ruralbytest/sesame-robot/docs/README.md

# Documentation

Documentation for the Sesame Robot project.

- **build-guide/** - Build guide with photos
- **images/** - Photos and diagrams
- **two-brain-build/** - Design record for the fork's body + round-head build: wiring for the XIAO and Glyph S3, PCA9685 variant, UART protocol, power, lessons learned
- **wiring-guide/** - Wiring instructions
