ruralbytest/sesame-robot/hardware/printing/stl/top-covers/aurora-head/Aurora-Ear-Cat-v200.stl

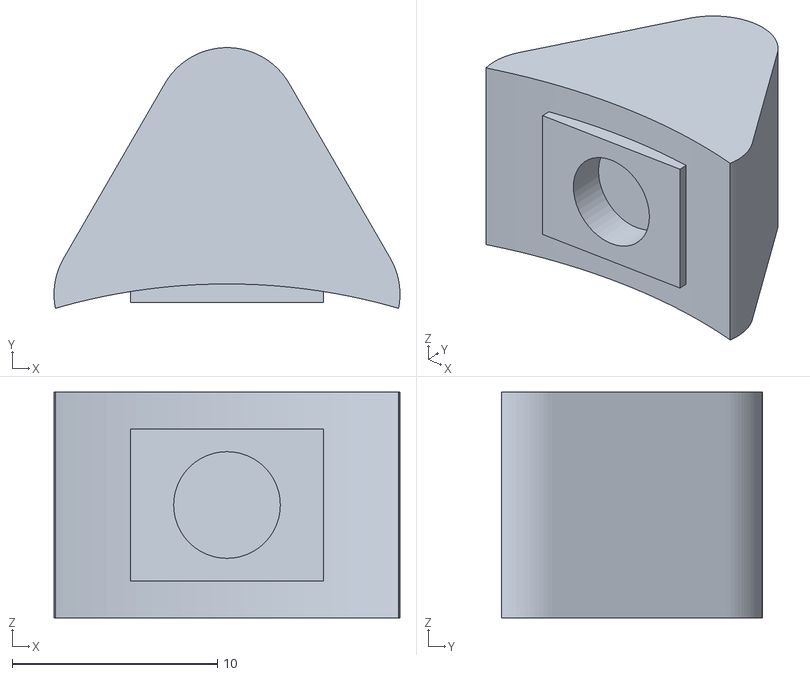
[picture p11: CAD file, 2026-10-20]
hardware/printing/stl/top-covers/aurora-head/Aurora-Ear-Cat-v200.stl
16.9 x 12.7 x 11.0
