ruralbytest/sesame-robot/hardware/printing/stl/top-covers/aurora-head/Aurora-Ear-Bunny-v200.stl

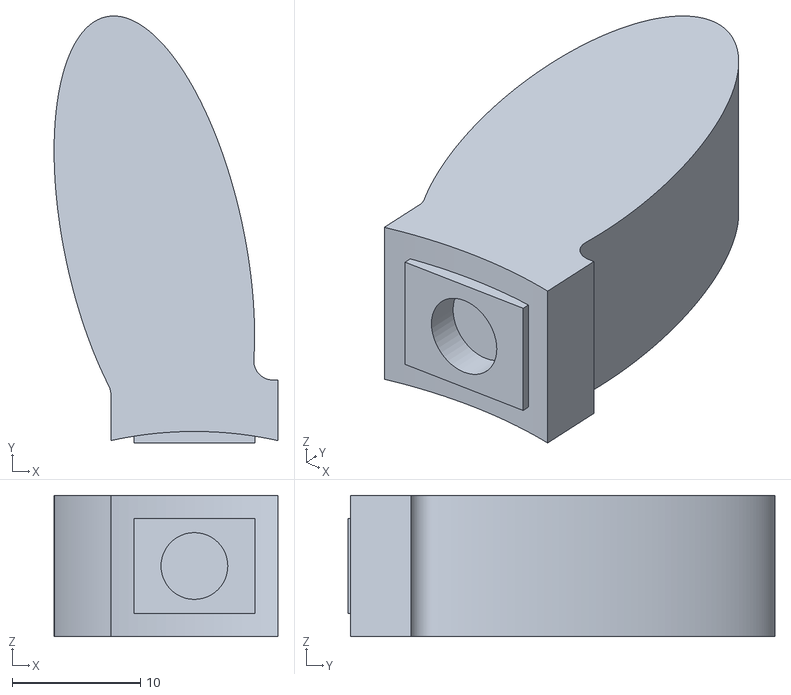
[picture p12: CAD file, 2026-10-20]
hardware/printing/stl/top-covers/aurora-head/Aurora-Ear-Bunny-v200.stl
17.4 x 33.2 x 11.0
