ruralbytest/sesame-robot/hardware/printing/stl/top-covers/aurora-head/Aurora-Head-Socket-Clamp-v200.stl

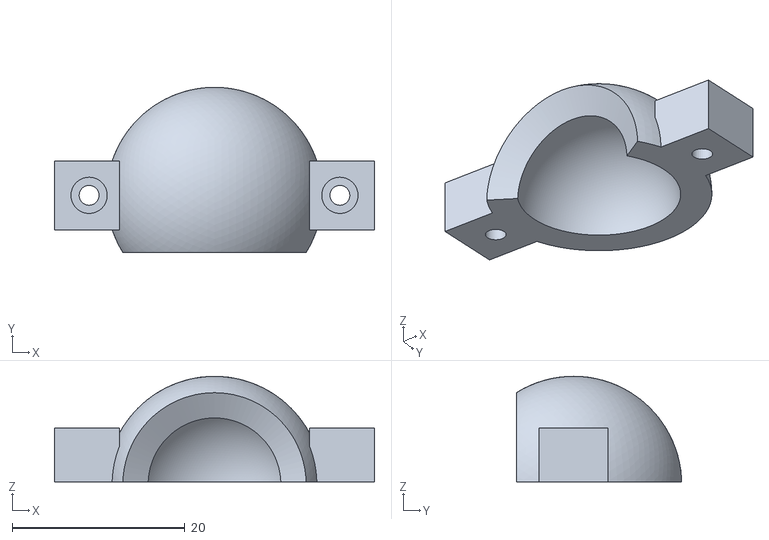
[picture p13: CAD file, 2026-10-20]
hardware/printing/stl/top-covers/aurora-head/Aurora-Head-Socket-Clamp-v200.stl
37.0 x 19.1 x 12.2
