ruralbytest/sesame-robot/hardware/printing/stl/top-covers/aurora-head/Aurora-Ear-Antenna-v200.stl

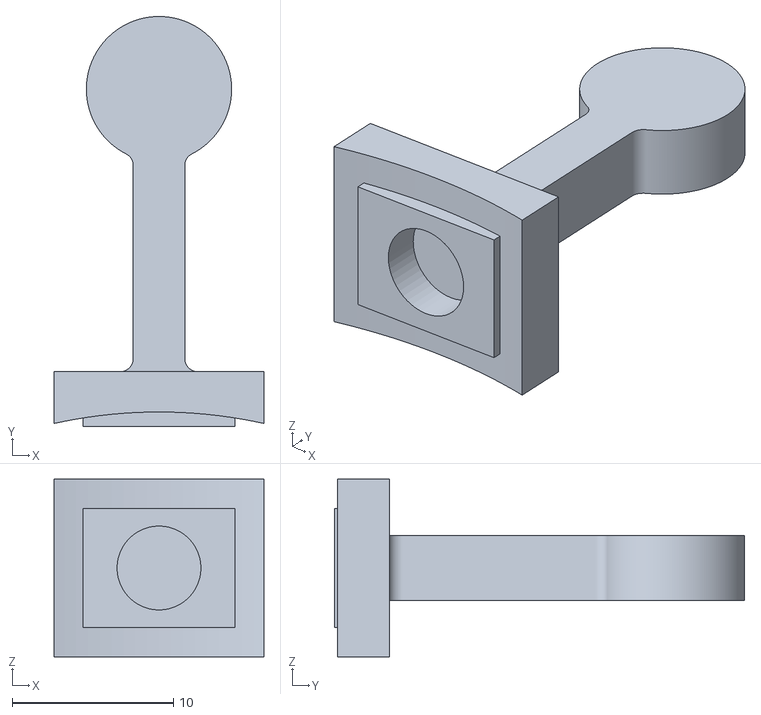
[picture p14: CAD file, 2026-10-20]
hardware/printing/stl/top-covers/aurora-head/Aurora-Ear-Antenna-v200.stl
13.0 x 25.4 x 11.0
