ruralbytest/sesame-robot/hardware/printing/stl/top-covers/aurora-head/Aurora-Head-Body-v200.stl

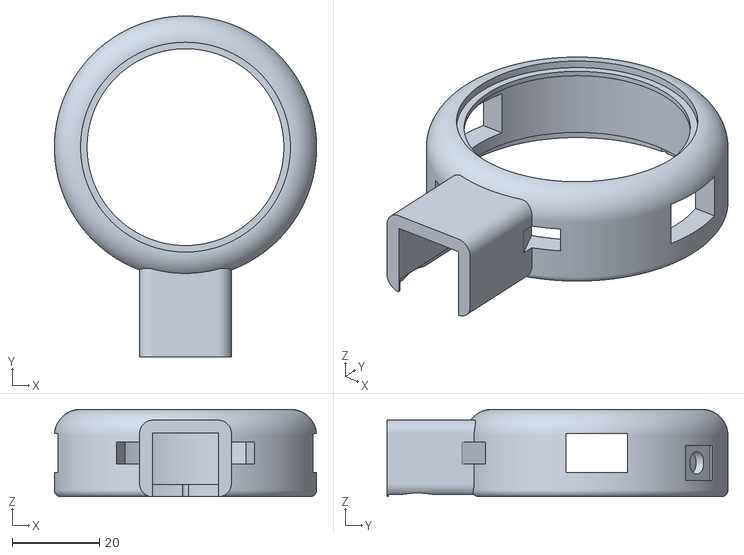
[picture p15: CAD file, 2026-10-20]
hardware/printing/stl/top-covers/aurora-head/Aurora-Head-Body-v200.stl
60.0 x 78.0 x 20.0
