ruralbytest/sesame-robot/hardware/printing/stl/top-covers/aurora-head/Aurora-Head-Back-Cap-v200.3mf

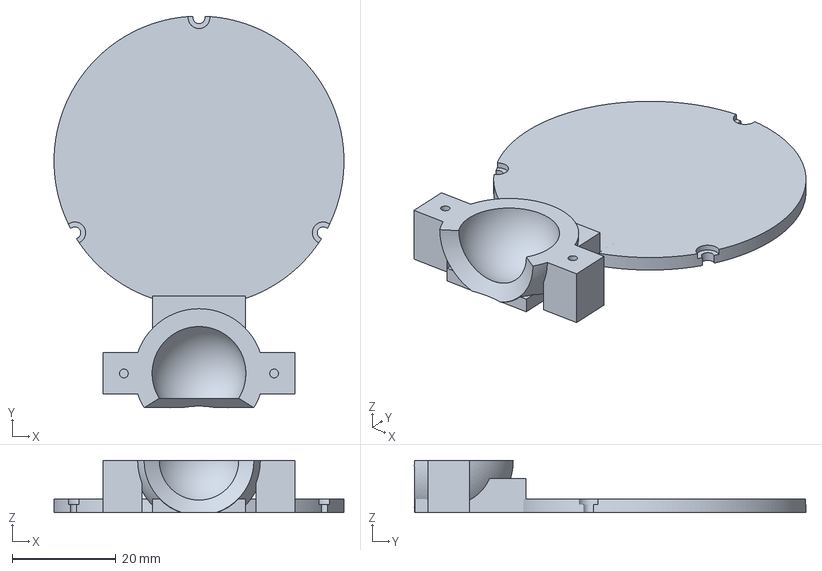
[picture p16: CAD file, 2026-10-20]
hardware/printing/stl/top-covers/aurora-head/Aurora-Head-Back-Cap-v200.3mf
56.0 x 75.6 x 10.1 mm
