ruralbytest/sesame-robot/hardware/printing/stl/top-covers/aurora-head/Aurora-Ear-Bear-v200.stl

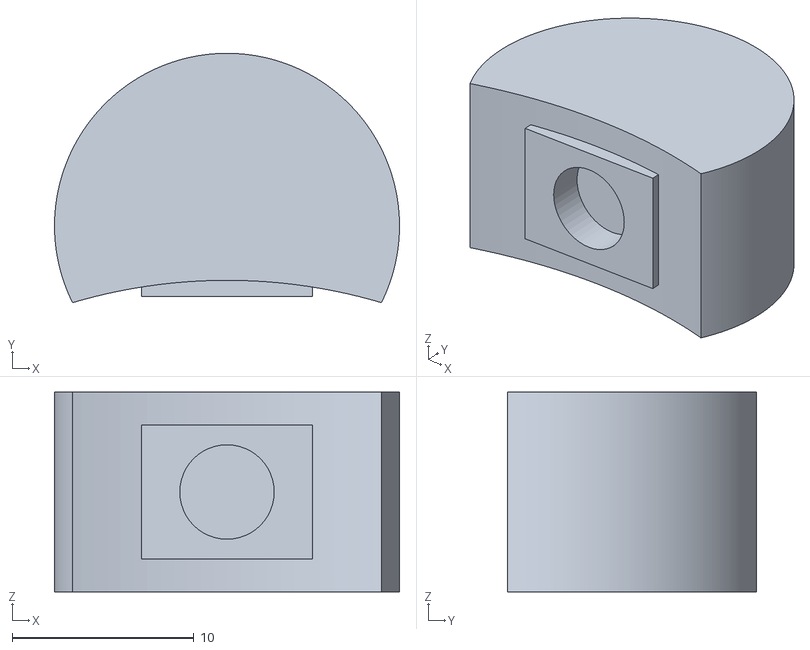
[picture p17: CAD file, 2026-10-20]
hardware/printing/stl/top-covers/aurora-head/Aurora-Ear-Bear-v200.stl
19.0 x 13.7 x 11.0
