ruralbytest/sesame-robot/hardware/printing/stl/top-covers/aurora-head/Top-Cover-Aurora-v200.stl

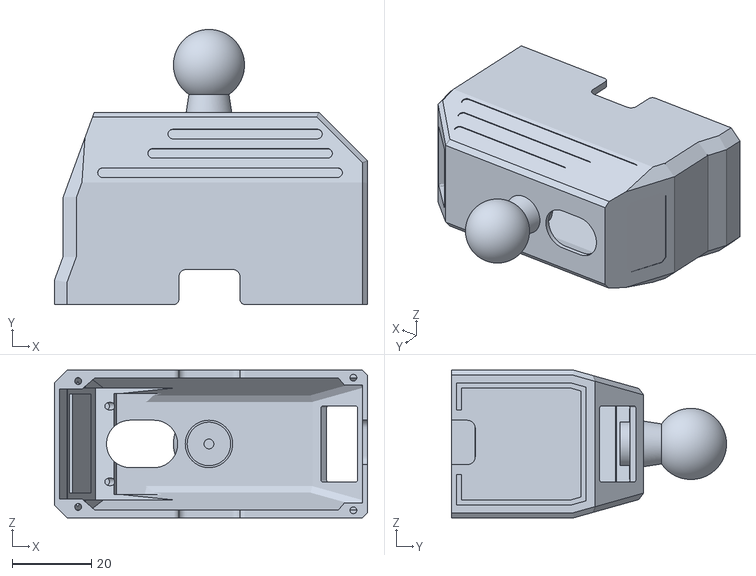
[picture p18: CAD file, 2026-10-20]
hardware/printing/stl/top-covers/aurora-head/Top-Cover-Aurora-v200.stl
79.2 x 69.6 x 37.4
