ruralbytest/sesame-robot/(list of files, cad)

Other CAD files:
hardware/printing/stl/top-covers/aurora-head/Aurora-Head-Back-Cap-v200.stl
