ruralbytest/sesame-robot/hardware/printing/stl/top-covers/README.md

# Top Cover Styles

## Enclosed v100
Current modern version of sesame top cover, includes 5mm x 2mm magnet slots for hats! Front display wires are covered, supports multicolor details.

## Cat v100
Modern Version of the enclosed top cover with cat ears instead of stubby ears! Updated with all current features with magnet support for hats, and multicolor details.

## No Ears v100
Template for designing your own ears for Sesame. The areas right next to where the ears ussually go is a little thin so this version is only really meant for desiging ears onto. (Includes all previously mentioned features)

## Aurora Head v200
Top cover for the Waveshare 1.43" round AMOLED head (ESP32-S3-Touch-AMOLED-1.43C). The display sits in a round head on a ball joint, so you can tilt and turn it by hand, with swappable magnet-mounted ears (cat, bunny, bear, antenna). The OLED window is filled in. Built on the No-Ears cover so leg clearance is unchanged. See [aurora-head](aurora-head/README.md) for the parts, screws and assembly steps.
