ruralbytest/sesame-robot/firmware/head-firmware/sesame-aurora/Audio.cpp

#include "Audio.h"
#include <driver/i2s_tdm.h>
#include <math.h>
#include "src/esp_codec_dev/include/esp_codec_dev.h"
#include "src/esp_codec_dev/include/esp_codec_dev_defaults.h"

i2c_master_bus_handle_t sharedBus=nullptr;
static i2c_master_dev_handle_t touch=nullptr;
static esp_codec_dev_handle_t speaker=nullptr,microphone=nullptr;
static QueueHandle_t notes=nullptr;
std::atomic<float> micLevel{0};
std::atomic<uint32_t> audioBlocks{0},audioErrors{0},soundUntil{0};
std::atomic<bool> soundEnabled{true};
// The amplifier (PA) is switched off between sounds to save power and avoid
// hiss. It gets a short silent lead-in after switching on so the start of a
// sound isn't clipped, and stays on briefly afterwards so the tail plays out.
std::atomic<bool> ampOn{false};
static constexpr gpio_num_t PA_PIN=GPIO_NUM_46;
static constexpr int AMP_WARMUP_BLOCKS=2;     // 2 x 16 ms of silence after switching on
static constexpr uint32_t AMP_OFF_AFTER_MS=500;
static void setAmp(bool on){gpio_set_level(PA_PIN,on);ampOn.store(on);}
// Volume 0..100 maps to -50..0 dB in the codec; 100 = full DAC level.
// Raise CHIRP_AMPLITUDE/SPEAKER_VOLUME together if calls are still too quiet.
static constexpr int SPEAKER_VOLUME=100;
static constexpr float CHIRP_AMPLITUDE=24000;
bool micReady=false,speakerReady=false;

// A sound is a short series of tones. Each tone glides from f0 to f1 Hz,
// bends up by `arch` Hz in the middle, wobbles by vibDepth Hz at vibHz,
// and lasts ms milliseconds. f0 = 0 is a silent gap.
struct Tone{uint16_t f0,f1;int16_t arch;uint8_t vibHz;uint8_t vibDepth;uint16_t ms;};
struct Sound{uint8_t count;Tone tones[7];};
#define GAP(ms) {0,0,0,0,0,ms}
#define NOTE(f,ms) {f,f,0,0,0,ms}
static const Sound sounds[SND_COUNT]={
  // Original pet calls
  {1,{{700,700,380,0,0,350}}},                                   // chirp
  {1,{{520,520,380,0,0,350}}},                                   // affection
  {1,{{180,180,0,6,65,700}}},                                    // purr
  // Moods: CURIOUS, HAPPY, LOVE, SLEEPY, PARTY, SURPRISED, BRAVE, SAD, THINKING
  {1,{{500,850,0,0,0,260}}},                                     // curious: rising "hm?"
  {3,{{700,1000,0,0,0,120},GAP(40),{800,1200,0,0,0,150}}},       // happy: two bright chirps
  {3,{{650,600,0,6,30,220},GAP(60),{560,520,0,6,30,280}}},       // love: soft "mm-mm"
  {1,{{600,250,60,5,15,700}}},                                   // sleepy: long yawn
  {4,{NOTE(523,90),NOTE(659,90),NOTE(784,90),NOTE(1047,160)}},   // party: arpeggio
  {1,{{400,1400,0,0,0,160}}},                                    // surprised: quick upward sweep
  {3,{{220,260,0,30,20,160},GAP(40),{330,330,0,30,20,260}}},     // brave: low growl
  {3,{{700,420,0,5,15,420},GAP(60),{450,330,0,5,15,320}}},       // sad: falling sigh
  {2,{{300,300,0,5,10,320},{300,430,0,0,0,160}}},                // thinking: "hmm?"
  // Body moves, in Move order
  {5,{{600,660,0,0,0,60},GAP(50),{520,580,0,0,0,60},GAP(50),{600,660,0,0,0,60}}},   // forward: pit-pat steps
  {3,{NOTE(1000,130),GAP(110),NOTE(1000,130)}},                  // backward: reversing beeps
  {1,{{950,600,0,0,0,220}}},                                     // left: falling swoop
  {1,{{600,950,0,0,0,220}}},                                     // right: rising swoop
  {3,{{480,280,80,5,15,650},GAP(80),{300,260,0,0,0,180}}},       // rest: yawn and sigh
  {3,{NOTE(523,100),GAP(30),NOTE(784,240)}},                     // stand: ta-da
  {3,{{700,900,0,0,0,130},GAP(40),{900,650,0,0,0,220}}},         // wave: "hel-lo"
  {6,{NOTE(523,90),NOTE(659,90),NOTE(784,90),NOTE(1047,90),NOTE(784,90),NOTE(1047,180)}}, // dance
  {5,{{400,900,0,0,0,50},GAP(50),{450,950,0,0,0,50},GAP(50),{500,1000,0,0,0,50}}},  // swim: bubbles
  {3,{NOTE(1250,90),GAP(30),NOTE(1570,200)}},                    // point: "ding-ding"
  {5,{{250,330,0,0,0,110},GAP(120),{250,330,0,0,0,110},GAP(120),{280,380,0,0,0,160}}}, // pushup: hup hup hup
  {3,{NOTE(784,120),NOTE(659,120),NOTE(523,220)}},               // bow: polite descent
  {1,{{900,1200,150,8,40,380}}},                                 // cute: "nya~"
  {1,{{300,1200,0,15,250,600}}},                                 // freaky: wild warble
  {1,{{500,700,0,10,120,520}}},                                  // worm: wiggly glide
  {1,{{700,700,0,25,200,420}}},                                  // shake: fast trill
  {3,{{450,350,0,0,0,160},GAP(60),{380,500,0,0,0,220}}},         // shrug: "meh?"
  {1,{{600,150,0,4,20,900}}},                                    // dead: long fall
  {7,{NOTE(1500,30),GAP(60),NOTE(1500,30),GAP(60),NOTE(1500,30),GAP(60),NOTE(1800,40)}}, // crab: clicks
};
static uint32_t soundMs(int id){uint32_t ms=0;for(int i=0;i<sounds[id].count;i++)ms+=sounds[id].tones[i].ms;return ms;}

void playSound(int id){if(notes&&speakerReady&&soundEnabled.load()&&id>=0&&id<SND_COUNT)xQueueOverwrite(notes,&id);}

static void audioTask(void*) {
  int16_t in[512],out[512]; // 256 stereo samples: 16 ms at 16 kHz
  int sound=-1,tone=0,pos=0,len=0,warmup=0;float phase=0;uint32_t quietSince=millis();
  if(speakerReady)setAmp(false); // the codec switched it on when it opened
  for(;;){
    int request=0;
    if(xQueueReceive(notes,&request,0)==pdTRUE){
      sound=request;tone=0;pos=0;len=sounds[sound].tones[0].ms*16;
      if(!ampOn.load()){setAmp(true);warmup=AMP_WARMUP_BLOCKS;}
      soundUntil.store(millis()+warmup*16+soundMs(sound)+350);
    }
    if(!soundEnabled.load())sound=-1; // muted mid-sound: drop it so the amp can switch off
    if(micReady){
      if(esp_codec_dev_read(microphone,in,sizeof(in))==ESP_OK){
        // Remove DC separately for both channels; use the louder microphone.
        float mean[2]={0,0},sum[2]={0,0};
        for(int i=0;i<512;i++)mean[i&1]+=in[i]/256.f;
        for(int i=0;i<512;i++)sum[i&1]+=fabsf(in[i]-mean[i&1]);
        float level=fmaxf(sum[0],sum[1])/256.f/32768.f;
        micLevel.store(level);audioBlocks.fetch_add(1);
      }else{audioErrors.fetch_add(1);vTaskDelay(pdMS_TO_TICKS(10));}
    }
    for(int i=0;i<256;i++){
      float sample=0;
      if(sound>=0 && soundEnabled.load() && !warmup){
        const Tone& k=sounds[sound].tones[tone];
        if(k.f0){
          float t=pos/16000.f,u=pos/(float)len;
          float f=k.f0+(k.f1-k.f0)*u+k.arch*sinf(u*3.14159f)+k.vibDepth*sinf(6.2831853f*k.vibHz*t);
          float envelope=fminf(1.f,u*18)*fminf(1.f,(1-u)*12);
          // Synthesized calls with a soft envelope per tone. Peak is
          // 1.18 * CHIRP_AMPLITUDE, kept just under int16 full scale.
          phase+=6.2831853f*f/16000; if(phase>6.2831853f)phase-=6.2831853f;
          sample=(sinf(phase)+.18f*sinf(phase*2))*envelope*CHIRP_AMPLITUDE;
        }
        if(++pos>=len){
          pos=0;
          if(++tone>=sounds[sound].count)sound=-1;
          else len=sounds[sound].tones[tone].ms*16;
        }
      }
      out[i*2]=out[i*2+1]=(int16_t)sample;
    }
    if(warmup)warmup--;
    if(sound>=0)quietSince=millis();
    else if(ampOn.load()&&millis()-quietSince>AMP_OFF_AFTER_MS)setAmp(false);
    if(speakerReady){if(esp_codec_dev_write(speaker,out,sizeof(out))!=ESP_OK){audioErrors.fetch_add(1);vTaskDelay(pdMS_TO_TICKS(10));}}
    if(!micReady&&!speakerReady)vTaskDelay(pdMS_TO_TICKS(30));
  }
}

bool readTouch(int &x,int &y){
  if(!touch)return false;uint8_t reg=2,b[5]={};
  if(i2c_master_transmit_receive(touch,&reg,1,b,5,20)!=ESP_OK)return false;
  if(!(b[0]&15)||(b[1]>>6)==1)return false;
  // Panel MADCTL rotates 180 degrees; match its visible coordinates.
  x=465-(((b[1]&15)<<8)|b[2]);y=465-(((b[3]&15)<<8)|b[4]);
  return x>=0&&x<466&&y>=0&&y<466;
}

bool initPeripherals(){
  pinMode(18,OUTPUT);digitalWrite(18,HIGH); // codec LDO (official BSP)
  pinMode(46,OUTPUT);digitalWrite(46,LOW); // PA off until codec is ready
  i2c_master_bus_config_t bus={};bus.i2c_port=I2C_NUM_0;bus.sda_io_num=GPIO_NUM_47;bus.scl_io_num=GPIO_NUM_48;
  bus.clk_source=I2C_CLK_SRC_DEFAULT;bus.glitch_ignore_cnt=7;bus.flags.enable_internal_pullup=true;
  if(i2c_new_master_bus(&bus,&sharedBus)!=ESP_OK)return false;
  pinMode(16,OUTPUT);digitalWrite(16,HIGH);delay(20);digitalWrite(16,LOW);delay(20);digitalWrite(16,HIGH);delay(150);
  if(i2c_master_probe(sharedBus,0x15,30)==ESP_OK){
    i2c_device_config_t t={};t.dev_addr_length=I2C_ADDR_BIT_LEN_7;t.device_address=0x15;t.scl_speed_hz=400000;
    i2c_master_bus_add_device(sharedBus,&t,&touch);
  }
  bool hasSpk=i2c_master_probe(sharedBus,0x18,30)==ESP_OK;
  bool hasMic=i2c_master_probe(sharedBus,0x40,30)==ESP_OK;
  Serial.printf("I2C touch=%d speaker=%d microphone=%d\n",touch!=nullptr,hasSpk,hasMic);
  if(!hasSpk&&!hasMic)return touch!=nullptr;
  i2s_chan_handle_t tx=nullptr,rx=nullptr;
  i2s_chan_config_t ch=I2S_CHANNEL_DEFAULT_CONFIG(I2S_NUM_0,I2S_ROLE_MASTER);ch.auto_clear=true;
  if(i2s_new_channel(&ch,&tx,&rx)!=ESP_OK)return touch!=nullptr;
  i2s_tdm_config_t cfg={};cfg.clk_cfg=I2S_TDM_CLK_DEFAULT_CONFIG(16000);
  cfg.slot_cfg=I2S_TDM_PHILIPS_SLOT_DEFAULT_CONFIG(I2S_DATA_BIT_WIDTH_16BIT,I2S_SLOT_MODE_STEREO,(i2s_tdm_slot_mask_t)(I2S_TDM_SLOT0|I2S_TDM_SLOT1));cfg.slot_cfg.total_slot=2;
  cfg.gpio_cfg.mclk=GPIO_NUM_38;cfg.gpio_cfg.bclk=GPIO_NUM_39;cfg.gpio_cfg.ws=GPIO_NUM_40;cfg.gpio_cfg.dout=GPIO_NUM_41;cfg.gpio_cfg.din=GPIO_NUM_42;
  if(i2s_channel_init_tdm_mode(tx,&cfg)!=ESP_OK||i2s_channel_init_tdm_mode(rx,&cfg)!=ESP_OK)return touch!=nullptr;
  i2s_channel_enable(tx);i2s_channel_enable(rx);
  audio_codec_i2s_cfg_t dataCfg={};dataCfg.port=0;dataCfg.tx_handle=tx;dataCfg.rx_handle=rx;
  auto data=audio_codec_new_i2s_data(&dataCfg);
  auto gpio=audio_codec_new_gpio();
  audio_codec_i2c_cfg_t ctl={};ctl.port=0;ctl.bus_handle=sharedBus;
  esp_codec_dev_sample_info_t fs={};fs.sample_rate=16000;fs.channel=2;fs.bits_per_sample=16;
  if(hasSpk){
    ctl.addr=ES8311_CODEC_DEFAULT_ADDR;
    es8311_codec_cfg_t c={};c.ctrl_if=audio_codec_new_i2c_ctrl(&ctl);c.gpio_if=gpio;c.codec_mode=ESP_CODEC_DEV_WORK_MODE_DAC;c.pa_pin=46;c.use_mclk=true;c.hw_gain.pa_gain=6;
    auto codec=es8311_codec_new(&c);
    if(codec&&data){esp_codec_dev_cfg_t d={};d.dev_type=ESP_CODEC_DEV_TYPE_OUT;d.codec_if=codec;d.data_if=data;speaker=esp_codec_dev_new(&d);}
    speakerReady=speaker&&esp_codec_dev_open(speaker,&fs)==ESP_OK;
    if(speakerReady){esp_codec_dev_set_out_vol(speaker,SPEAKER_VOLUME);esp_codec_dev_set_out_mute(speaker,false);}
  }
  if(hasMic){
    ctl.addr=ES7210_CODEC_DEFAULT_ADDR;
    es7210_codec_cfg_t c={};c.ctrl_if=audio_codec_new_i2c_ctrl(&ctl);c.mic_selected=ES7120_SEL_MIC1|ES7120_SEL_MIC2|ES7120_SEL_MIC3|ES7120_SEL_MIC4;
    auto codec=es7210_codec_new(&c);
    if(codec&&data){esp_codec_dev_cfg_t d={};d.dev_type=ESP_CODEC_DEV_TYPE_IN;d.codec_if=codec;d.data_if=data;microphone=esp_codec_dev_new(&d);}
    micReady=microphone&&esp_codec_dev_open(microphone,&fs)==ESP_OK;
    if(micReady)esp_codec_dev_set_in_gain(microphone,24);
  }
  notes=xQueueCreate(1,sizeof(int));
  if(notes&&(micReady||speakerReady))xTaskCreatePinnedToCore(audioTask,"pet_audio",6144,nullptr,2,nullptr,0);
  Serial.printf("Audio mic=%d speaker=%d\n",micReady,speakerReady);
  return touch!=nullptr;
}
