ruralbytest/sesame-robot/(commit log)

2026-10-16 Add Seeed Studio XIAO ESP32-S3 board support
    - sesame-firmware-main.ino: auto-detected XIAO branch (ARDUINO_XIAO_ESP32S3)
    selects I2C pins (D4/D5) and servoPins[] {1, 4, 3, 2, 7, 9, 43, 8}
    (R1=D0 R2=D3 L1=D2 L2=D1 R4=D8 R3=D10 L3=D6 L4=D9); other boards
    keep the existing comment/uncomment blocks in the #else branch
    - debugging-firmware/xiao-mapping-tester: one-servo-at-a-time wiring checker
    - sesame-motor-tester.ino: commented XIAO pin option
    - firmware/README.md, hardware/bom/README.md, README.md: XIAO flashing
    steps, pin table and BOM note
    - CLAUDE.md: repo guidance for Claude Code
    Ported from shahulabdul/sesame-robot-xiao-esp32-s3 onto current upstream.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
2026-10-18 Add XIAO head link: face on a separate head board over UART
    - sesame-firmware-main.ino: on the XIAO, XIAO_HEAD_LINK (default 1) drops
    the SSD1306 OLED and talks to a Waveshare ESP32-S3-Touch-AMOLED-1.43C
    head over UART1 on D6 (TX, GPIO43) / D7 (RX, GPIO44) at 115200.
    Body -> head: "F:<face>,<mode>" on every face/mode change, repeated
    every 3 s so a rebooted head re-syncs. Head -> body: "C:<command>" sets
    currentCommand (polled inside delayWithFace/pressingCheck too), "C:stop"
    stops. Non-protocol lines (boot log) are ignored. New servo pin map
    {1,2,3,4,5,6,7,8} keeps servos off boot-log pins.
    - -DXIAO_HEAD_LINK=0 restores the XIAO + OLED build (byte-identical size).
    - xiao-mappi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
    [sesame-firmware-main.ino, xiao-mapping-tester.ino]
2026-10-18 Add head firmware for the Waveshare 1.43C round AMOLED
    - firmware/head-firmware/sesame-head: new sketch for the head board.
    Draws the existing 128x64 faces from face-bitmaps.h scaled x3
    (384x192, centred at even coordinates as the panel requires), plays
    loop/once/boomerang animations at the body's frame rates, and listens
    for "F:<face>,<mode>" on UART1 (RX GPIO44 / TX GPIO43) and on USB
    Serial for testing. Repeats of the current face are ignored (the body
    re-sends every 3 s); unknown names show the default face; non-F: lines
    (boot log) are ignored.
    - Display via ESP-IDF esp_lcd with Espressif's SH8601 QSPI panel driver
    (Apache-2.0) vendored from Waveshare's demo, using its in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
2026-10-19 Add Sesame Aurora head firmware and head boot log
    sesame-aurora is a standalone animated-pet head for the Waveshare 1.43C
    AMOLED: drawn characters, mic-reactive halo, synthesized pet sounds,
    and a Wi-Fi control page. The character is cached in PSRAM and shifted
    per frame rather than redrawn, which keeps the frame rate up.
    sesame-head now keeps a boot log in RTC memory (reset reason, how far
    setup got, panel registers) so resets can be diagnosed after the fact.
    [Audio.cpp, Audio.h, Aurora.cpp, Painter.h, Scene.cpp, Scene.h]
2026-10-19 Let touching the Aurora head make the body do tricks
    Double-tap sends the next one-shot trick (wave, bow, dance, cute, point,
    shrug) as C:<trick>. Any touch while the body moves, or a 1 s hold, sends
    C:stop. Tap and swipe are unchanged; showcase moves to BOOT and the web
    page only. A "Touch moves body" switch (web page, BODY:0/1 over USB) is
    on at boot. Mic surprise reactions pause while the body moves.
    Also add VOICE-COMMANDS-PLAN.md: a plan (not implemented) for offline
    spoken commands with ESP-SR on the head's 8 MB flash.
2026-10-19 Show battery level on the Aurora head and log why it restarts
    A phone-style battery icon with a percentage sits under the character
    name (red at 15% or less, green with a bolt while charging). Voltage is
    read on GPIO4 (half the cell voltage), charging on GPIO7 (ETA6098 STAT),
    pins from Waveshare's ADC example. The font gains digits and '%'.
    The web page and the '?' status add voltage, lowest voltage since boot,
    charging, uptime, the start reason and a brownout count kept in flash.
    The cold-start workaround's own restart no longer hides the real reason:
    it is carried across in RTC memory.
    Known issue: on this board, GPIO7 read "not charging" while on USB with
    the battery connected at 4.02 V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
    [Aurora.cpp, Painter.h, Scene.cpp, Scene.h]
2026-10-19 Infer charging on the Aurora head and add a "Battery fitted" switch
    The charger's STAT pin (GPIO7 in Waveshare's example) read "not charging"
    while charging, and the schematic doesn't show it reaching the ESP32
    usably. Charging is now inferred: USB connected to a computer, or the
    battery voltage rising over a minute (wall charger).
    With no battery the voltage reading is the charger's own ~4.17 V, which
    looks like a full battery, so the icon showed a fake 97% and a bolt. The
    icon now shows only when "Battery fitted" is on (web page, BATTERY:0/1
    over USB). The setting is saved in flash and starts off.
    [Aurora.cpp]
2026-10-19 Speed up the Aurora head's screen updates and drop old-body support
    The head now prepares the next strip of the picture while the current
    one is being sent, using two DMA strip buffers. Measured 13.7 -> 16.9 fps,
    for 22 KB of internal RAM.
    Moves now come only from the body's "M:" lines. The old path that read
    moves from face names also showed REST and a yawn when the body booted.
    The README lists two power savers planned for when a battery goes back
    in: Wi-Fi off when unused, and the speaker amplifier off when silent.
2026-10-19 Draw and send Aurora head frames on separate cores
    The main loop (core 1) now draws each frame into one of two PSRAM frame
    buffers while a screen task on core 0 sends the other. Measured
    16.9 -> 19.8 fps (the 20 fps cap), for one more 434 KB PSRAM buffer and
    a 4 KB task stack. The brightness refresh moved into the screen task so
    only one task talks to the panel. SNAP now sends the last finished frame.
    [Aurora.cpp]
2026-10-19 Switch the Aurora head's speaker amp off when silent and add Wi-Fi auto-off
    The speaker amplifier (PA, GPIO46) used to stay on, fed silence. It now
    switches on with ~30 ms of silent lead-in before each sound and off half
    a second after the sound ends. Muting mid-sound now drops the sound
    instead of freezing it, so the amp can switch off. `?` shows `amp`.
    The control page has a Wi-Fi section: turn the access point off after
    5/10/15/30/60 minutes with no phone connected (default never, saved in
    NVS). A connected phone keeps it on. A restart or `WIFI:ON` over USB
    brings it back; `WIFIOFF:<min>` sets it over USB. `?` shows `wifi`,
    `wifiOff` and `phones`. Turning Wi-Fi off frees about 29 KB of h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
2026-10-19 Offer 1, 3 or 5 minutes for the Aurora head's Wi-Fi auto-off
    The choices are now never, 1, 3 and 5 minutes (was never, 5, 10, 15, 30
    and 60). A saved value no longer offered falls back to never.
    [Aurora.cpp]
2026-10-19 Default the Aurora head's Wi-Fi auto-off to 1 minute
    A head with no saved choice, or a saved value no longer offered, now
    turns Wi-Fi off after 1 minute with no phone connected (was never).
    [Aurora.cpp]
2026-10-19 Add the Aurora head top cover for the 1.43" round AMOLED
    A cat-eared round head shell for the Waveshare ESP32-S3-Touch-AMOLED-1.43C
    on a short neck at the front of the body, plus a top cover built on the
    No-Ears cover: 15 mm taller, neck collar with a deep socket and locking
    screw, and the old OLED window filled in. The USB-C plug and UART wires
    run down an open slot in the neck that the back cap's tongue closes.
    Parts are generated by hardware/cad/aurora-head/generate_aurora_head.py
    (trimesh + manifold3d), which also checks display and plug clearance and
    that the exported STLs reload watertight.
    [Aurora-Head-Back-Cap-v100.stl, Aurora-Head-Body-v100.stl, Top-Cover-Aurora-v100.stl]
2026-10-19 Add PCBCupid Glyph ESP32-S3 board support
    Auto-detected from the "Pcbcupid GLYPH S3" / "S3 PSRAM" boards. Servos on
    IO6-10 and IO13-15. Defaults to the round head board over UART1 (IO17/IO18);
    -DGLYPH_HEAD_LINK=0 uses the SSD1306 OLED on IO4/IO5 instead. IO1 (battery
    sense), IO21 (LED) and IO43/44 (USB serial) stay free.
    [Aurora-Head-Back-Cap-v100.stl, Aurora-Head-Body-v100.stl, Top-Cover-Aurora-v100.stl]
2026-10-19 Add an optional PCA9685 servo driver build (USE_PCA9685)
    Build with -DUSE_PCA9685=1 to drive the 8 servos from a PCA9685 at 0x40
    on the board's I2C pins (IO4/IO5 on the Glyph S3) instead of ESP32Servo.
    Servo index i goes to channel pcaChannels[i] (0-7), with the same
    732-2929 us pulse range, so poses, subtrim and stagger are unchanged.
    Works with the head link or the OLED on the same bus.
2026-10-20 Add an optional reversed-body build for the XIAO (XIAO_REVERSE_BODY)
    Setting XIAO_REVERSE_BODY to 1 swaps the robot's front and rear without
    rewiring: servoPins is reordered so each servo takes the role of the one
    diagonally across (R1<->L2, R2<->L1, R3<->L4, R4<->L3), which uses the same
    angles, so pose code is unchanged. Default 0 keeps the original layout.
    The XIAO mapping tester gets the same switch.
    [sesame-firmware-main.ino, xiao-mapping-tester.ino]
2026-10-20 Default to the PCA9685 servo driver and add Glyph pins to the motor tester
    USE_PCA9685 now defaults to 1, so a plain Arduino IDE build drives the
    servos through the PCA9685 at 0x40. The motor tester picks the Glyph S3
    servo pins automatically when built for the Glyph board.
2026-10-20 Fix PCA9685 servo pulse range so R3/L4 move in stand
    The PCA9685 build mapped 0-180 deg to 732-2929 us, copying the numbers
    passed to ESP32Servo's attach(). ESP32Servo clamps that maximum to
    2500 us, so the GPIO build never sent more than 2500 us. On the PCA
    build, stand sent the R3 and L4 knees to 180 deg = 2929 us, and these
    servos ignore pulses above about 2400 us, so they never moved.
    setServoAngle() now maps 0-180 deg to 732-2500 us, matching the GPIO
    build, and caps the pulse at PCA_SERVO_MAX_US (2400 us). Angles of
    about 170 deg and up now land on the same position. 90 deg moves from
    1830 us to 1616 us, so subtrims tuned on the old PCA build are stale.
    Also adds two Serial CLI debug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
    [sesame-firmware-main.ino]
2026-10-20 Aurora head v200: ball-joint head with swappable magnet ears
    The round 1.43" AMOLED head now sits on an 18 mm ball joint on the roof
    instead of a fixed stem, so it can be tilted (10 deg down to 24 deg up),
    turned and leaned by hand. A two-screw socket clamp at the back sets the
    joint stiffness. The ears are separate parts held by keyed 5 x 2 mm
    magnet sockets: cat, bunny, bear and a single antenna.
    The generator script builds all v200 parts and the assembly GLB, and
    checks the head against the cover across the tilt range. The README
    covers the new parts, hardware, assembly and design notes, with new
    renders for the tilt range, the ears and the exploded parts.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
    [Aurora-Ear-Antenna-v200.stl, Aurora-Ear-Bear-v200.stl, Aurora-Ear-Bunny-v200.stl, Aurora-Ear-Cat-v200.stl, Aurora-Head-Back-Cap-v200.3mf, Aurora-Head-Back-Cap-v200.stl, Aurora-Head-Body-v200.stl, Aurora-Head-Socket-Clamp-v200.stl]
2026-10-20 Default XIAO_REVERSE_BODY to 1 (front and rear swapped on the XIAO)
    XIAO builds now reorder servoPins diagonally by default, so the robot
    walks toward what was the rear. Build with -DXIAO_REVERSE_BODY=0 for the
    original orientation. Re-check subtrims after switching. Other boards,
    including the Glyph S3, are unaffected.
    The XIAO mapping tester defaults to 1 as well so it checks the same
    servo roles, and README and CLAUDE.md state the new default.
    [sesame-firmware-main.ino, xiao-mapping-tester.ino]
2026-10-23 Add NOTICE, mark modified Espressif driver, fix fork README references
    [esp_lcd_sh8601.c]
2026-10-23 Add two-brain build notes and Aurora head concept study to the docs
    Converted from the design pages into Markdown with Mermaid diagrams so
    they render on GitHub: wiring for the XIAO and Glyph S3 bodies, the
    PCA9685 variant, the UART head protocol, power budget, the R3/L4 pulse
    bug, build phases, and the ten Aurora head concepts with their renders.
